MAVProxyUser/SegwayNinebotE12ScooterRevival/cad/hole_gauge.png

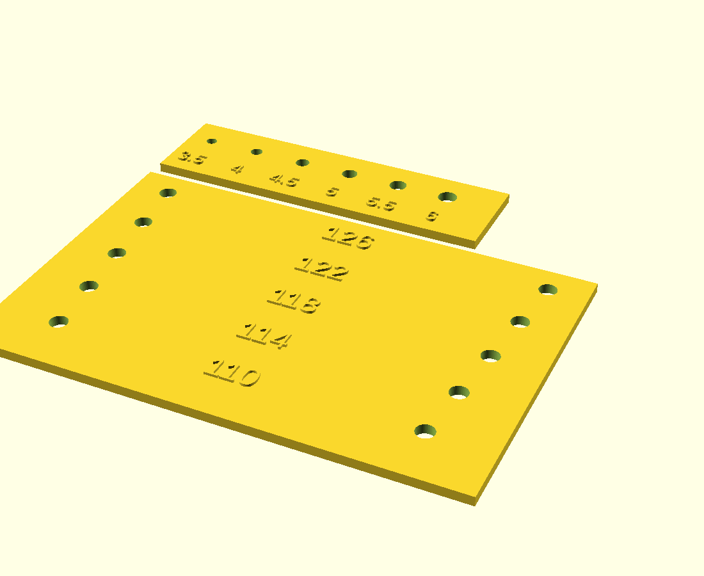
cad/hole_gauge.png
