MAVProxyUser/SegwayNinebotE12ScooterRevival/cad/slide_preview.png

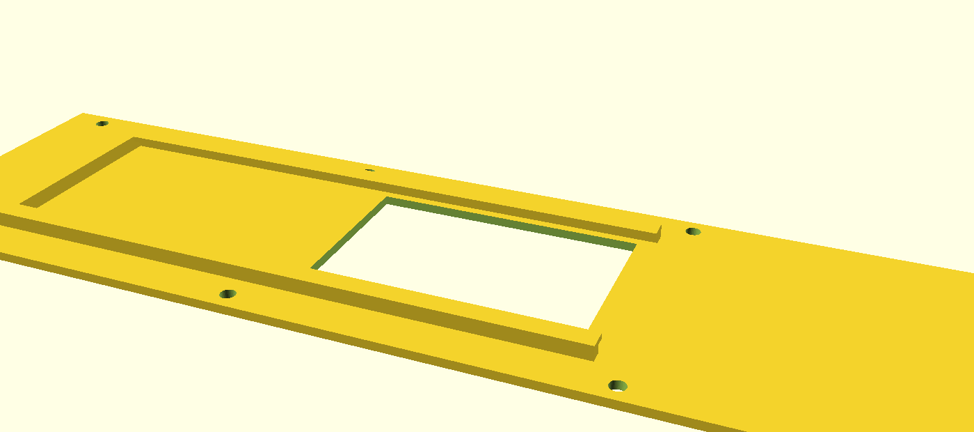
cad/slide_preview.png
