MAVProxyUser/SegwayNinebotE12ScooterRevival/cad/slide_door.stl

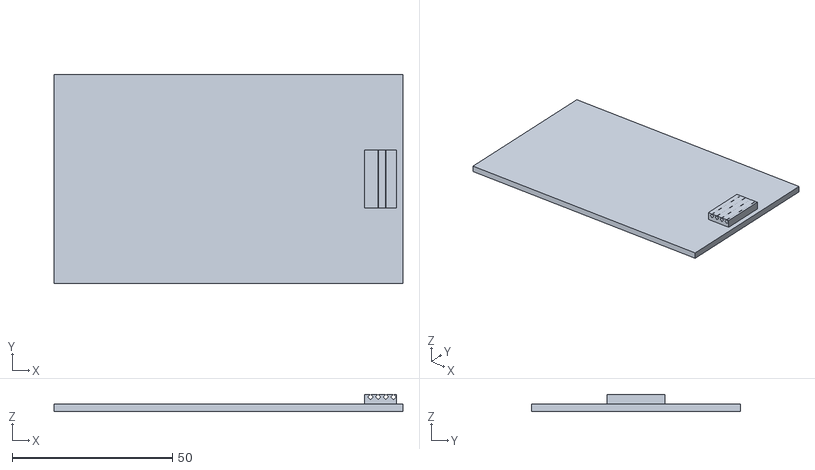
[picture p3: CAD file, 2026-10-19]
cad/slide_door.stl
109.0 x 65.2 x 5.40
