MAVProxyUser/SegwayNinebotE12ScooterRevival/cad/slide_baseB.stl

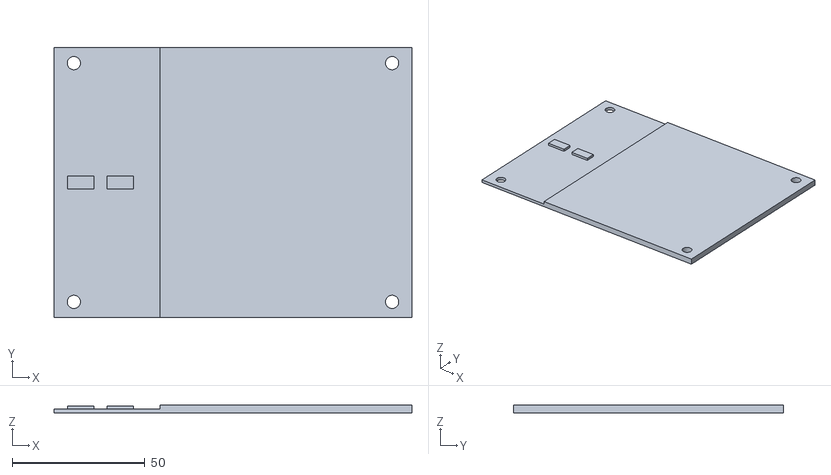
[picture p4: CAD file, 2026-10-19]
cad/slide_baseB.stl
135.0 x 102.0 x 3.00
