MAVProxyUser/SegwayNinebotE12ScooterRevival/cad/slide_baseA.stl

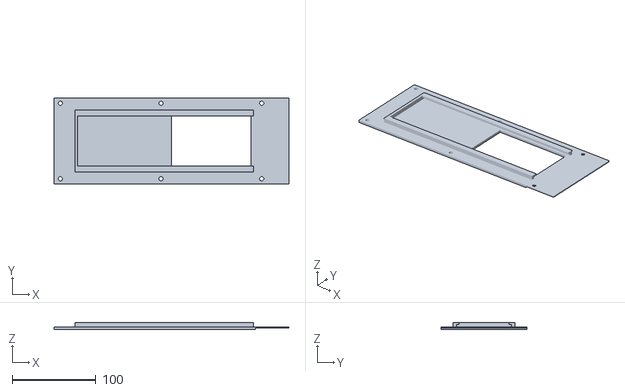
[picture p5: CAD file, 2026-10-19]
cad/slide_baseA.stl
280.0 x 102.0 x 8.00
