MAVProxyUser/SegwayNinebotE12ScooterRevival/cad/slide_base.stl

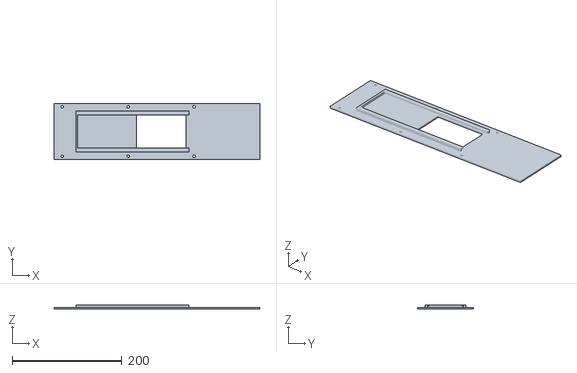
[picture p6: CAD file, 2026-10-18]
cad/slide_base.stl
375.0 x 102.0 x 8.00
