MAVProxyUser/SegwayNinebotE12ScooterRevival/cad/test_plate.stl

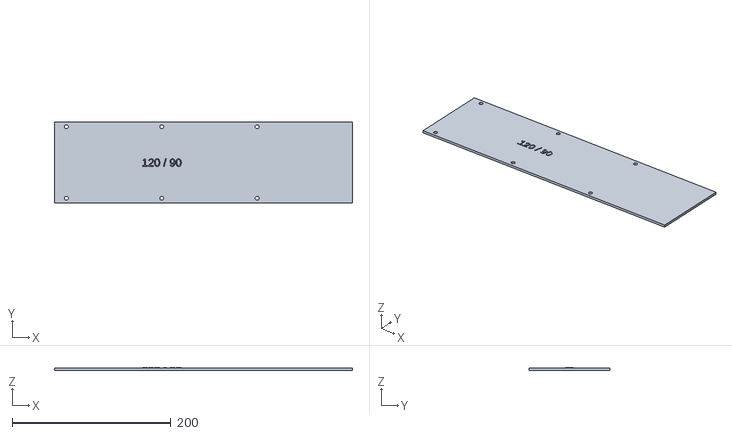
[picture p7: CAD file, 2026-10-18]
cad/test_plate.stl
375.0 x 102.0 x 3.80
