MAVProxyUser/SegwayNinebotE12ScooterRevival/cad/hole_gauge.stl

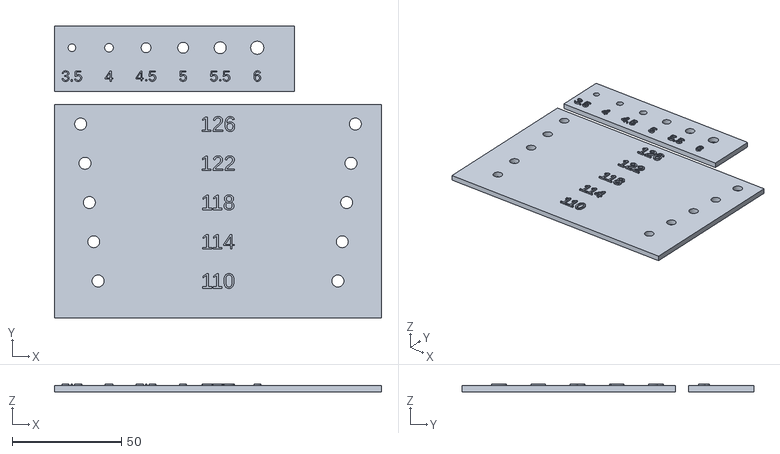
[picture p8: CAD file, 2026-10-18]
cad/hole_gauge.stl
150.0 x 134.0 x 3.80
