MAVProxyUser/SegwayNinebotE12ScooterRevival/cad/test_plate.png

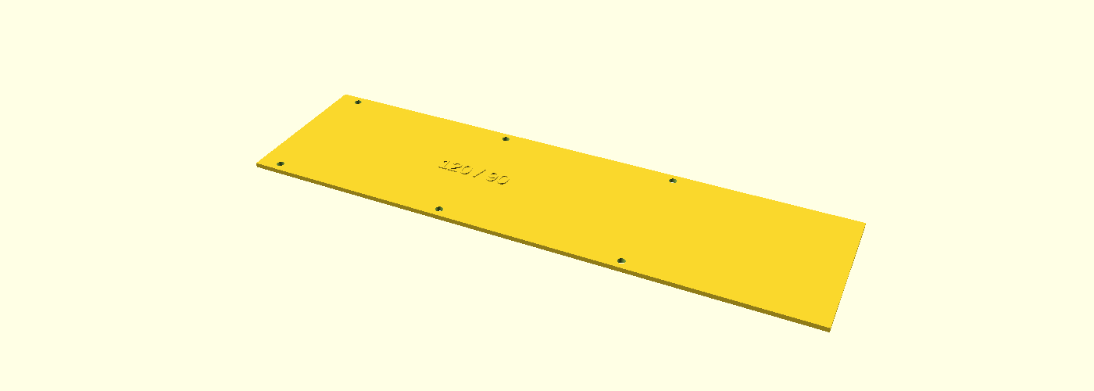
cad/test_plate.png
