MAVProxyUser/SegwayNinebotE12ScooterRevival/(commit log)

2026-10-17 Ninebot Zing E12 VESC conversion: docs, config and tooling
    Replaces the dead stock controller with a Flipsky Mini FSESC6.7 Pro driving
    the stock 150W rear hub motor, stock thumb throttle and stock brake lever.
    Working: throttle, proportional regen braking, road tested.
    Documents the measured motor constants (R 0.1363 ohm, L 352-365 uH,
    flux linkage 12.34-12.47 mWb, 30 poles), the full working VESC config,
    the control wiring, and the LiPo pack limits.
    Includes Python tooling that speaks the VESC packet protocol directly and
    can read/write any config parameter without the GUI, deriving the exact
    serializer layout from VESC Tool's own parameter XML rather than guessing
    byte offsets.
    Also rec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
    [01_hall_check.ino, 02_openloop_ramp.ino, 03_hall_closedloop.ino, apply_burnout.py, restore_config.py, vesc_adc.py, vesc_conf.py, vesc_live.py]
2026-10-18 Add printable hole-pattern gauge for the E12 deck plate
    Photo analysis gives a reliable scale (~108 px/inch, ~4% perspective
    variation across frame) but the holes are dark-on-black and could not be
    located reliably, so this measures the pitch rather than assuming it.
    Part A: five labelled hole pairs at 110-126mm bracketing the ~117mm visual
    estimate. Part B: 3.5-6mm diameter gauge.
    [hole_gauge.scad, hole_gauge.stl]
2026-10-18 Add test plate and sliding battery-access door
    Test plate: 3 hole pairs at 120mm pitch, 90mm across, as measured.
    Outline widened to 102mm because 90mm spacing on a 96mm plate leaves
    under 1mm of material at the edge.
    Sliding door: base plate with C-channel rails inboard of the mounting
    holes, plus a separate sliding panel. Opening sits between hole pairs
    so no fastener is lost. Exported as separate STLs for bed arrangement.
    [slide_base.stl, slide_door.scad, slide_door_panel.stl, test_plate.scad, test_plate.stl, test_plate_split.stl]
2026-10-18 Split slide base for sub-375mm build plates
    Split at x=280, chosen so the rails (40-246) and opening (150-240) and
    all three hole pairs stay wholly within part A - nothing that must stay
    aligned crosses the joint. Tongue placed on part B reaching back into A,
    so A's footprint is exactly the split length rather than split+lap.
    Part A 280x102, Part B 130x102, door 104x65.
    [slide_base_baseA.stl, slide_base_baseB.stl, slide_door.scad]
2026-10-18 Fix lap alignment pins landing outside the joint
    When the tongue moved from part A to part B the overlap region moved to
    x=245-280, but the pin offsets were still measured from the cut line,
    placing them at x=288-307 - past A's end entirely, so they aligned with
    nothing. Offsets are now measured from the start of the overlap.
    Verified by ray test: all three pin axes pass clear through both parts.
    [slide_base_baseA.stl, slide_base_baseB.stl, slide_door.scad]
2026-10-18 Replace lap pin holes with integral registration keys
    The three pin holes were useless on their own - they required 4mm pins
    that were never specified or modelled, so on the printed parts they read
    as arbitrary holes matching nothing in the mounting pattern.
    Replaced with two bosses on part B's tongue and matching pockets in part
    A's rebate. The halves now self-align and hold with glue alone, no
    separate hardware. Part B has no through-holes other than the mounting
    pattern.
    [slide_base_baseA.stl, slide_base_baseB.stl, slide_door.scad]
2026-10-18 Fix part B missing its mounting holes
    base_B() unioned the slab, tongue and keys inside a difference() with no
    subtraction - mount_holes() was never called. Part A only had holes
    because it is an intersection with base(), which does drill them.
    So part B had no fasteners at all regardless of pattern placement, which
    is why it could not attach to the frame.
    Also adds a centred-pattern variant: 3 pairs at 120mm centred on 375mm
    puts holes at 67.5/187.5/307.5 with 67.5mm margins, rather than 15/135/255
    which left the last 120mm of plate unsupported.
    [centred_baseA.stl, centred_baseB.stl, slide_base_baseB.stl, slide_door.scad, slide_door_centred.scad]
2026-10-19 4 hole pairs, split and lap corrected
    Pattern is 4 pairs, not 3: 120mm pitch spans 360mm on a 375mm plate, so
    holes sit at 7.5/127.5/247.5/367.5 with 7.5mm end margins. This matches
    the original photo read and means the plate never had an unsupported
    tail - the earlier centred variant was wrong and is removed.
    Split stays at x=280: part A keeps the rails, opening and three hole
    pairs, part B gets the fourth. The x=247.5 fastener now passes through
    the lap joint, so a real bolt clamps the halves.
    Lap deepened 35->40mm: at 35 the tongue began at x=245 and the 5mm hole
    at 247.5 spanned exactly 245-250, leaving the hole wall tangent to the
    tongue face and the mesh non-manifold. Rails trimmed 3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
    [centred_baseA.stl, centred_baseB.stl, slide_baseA.stl, slide_baseB.stl, slide_base_baseA.stl, slide_base_baseB.stl, slide_door.scad, slide_door.stl]
2026-10-20 Document the slide door and test plate in cad/README
    README only covered the hole gauge. Adds geometry, the split rationale,
    the slide mechanism, the lap joint and the tangency fix. Drops a stray
    debug render.
